Mozzie-AU/ESPLeafSOC/hardware/case/LeafSOCdisplay OLED 128x64 1p30in v09.stl

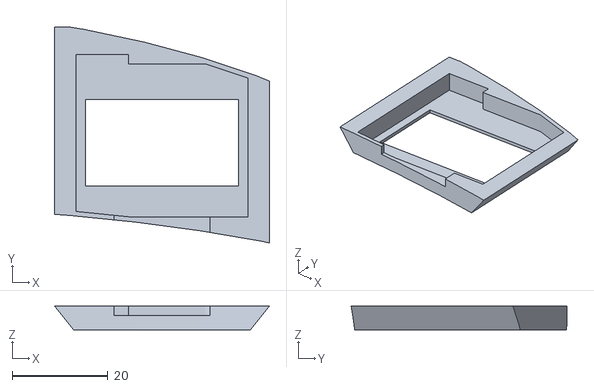
[picture p4: CAD file, 2026-06-22]
hardware/case/LeafSOCdisplay OLED 128x64 1p30in v09.stl
45.0 x 45.2 x 5.00
