Mozzie-AU/ESPLeafSOC/hardware/case/LeafSOCdisplay OLED 128x64 0p96inch v05.stl

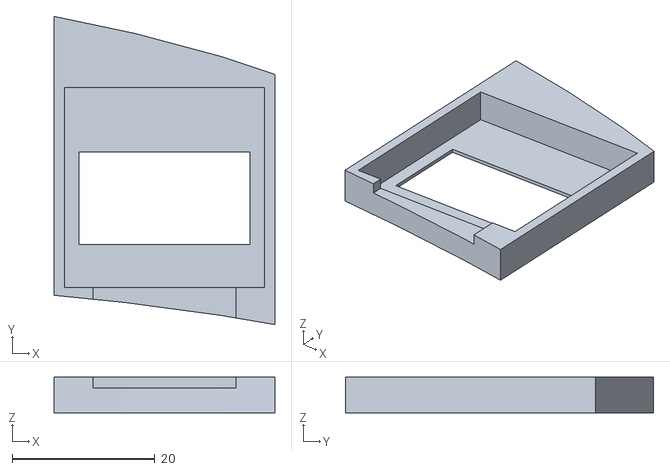
[picture p5: CAD file, 2026-06-22]
hardware/case/LeafSOCdisplay OLED 128x64 0p96inch v05.stl
31.0 x 43.2 x 5.00
