Mozzie-AU/ESPLeafSOC/hardware/case/LeafSOC box and lid v13.stl

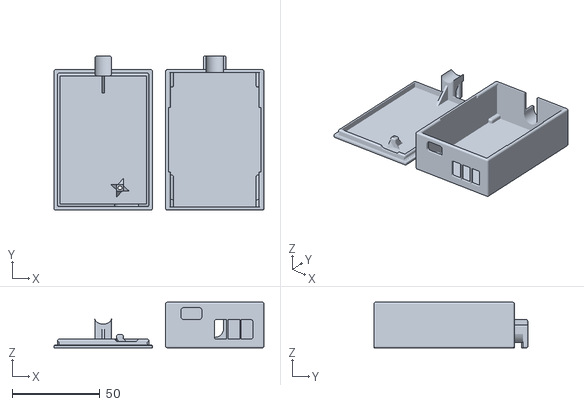
[picture p6: CAD file, 2026-06-22]
hardware/case/LeafSOC box and lid v13.stl
119.5 x 87.9 x 26.0
