Mozzie-AU/ESPLeafSOC/hardware/case/LeafSOCdisplay OLED 128x64 1p54inch v05.stl

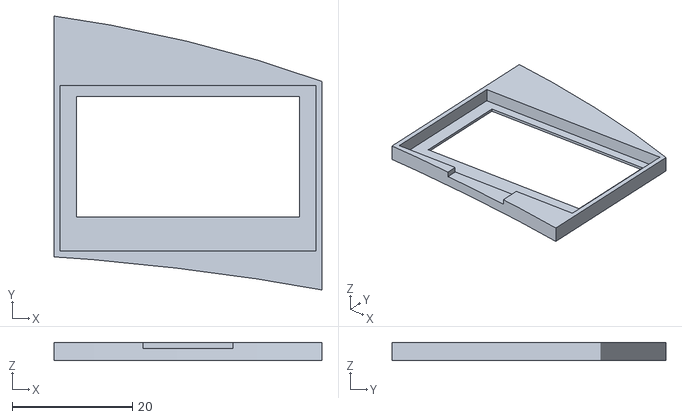
[picture p7: CAD file, 2026-06-22]
hardware/case/LeafSOCdisplay OLED 128x64 1p54inch v05.stl
44.5 x 45.5 x 3.00
