Mozzie-AU/ESPLeafSOC/(commit log)

2026-06-11 Remove old Arduino Nano ino files - ESP32 refactor starting
2026-06-11 Add ESPLeafSOC_v01.ino - initial ESP32 skeleton
2026-06-11 Add ESPLeafSOC_v01 - confirmed T-CAN485 pin assignments from pinout diagram
2026-06-11 Rename to ESPLeafSOC.ino - Arduino IDE requires sketch name matches folder
2026-06-12 v02 - Switch OLED to hardware SPI, dual SH1106/SSD1306 constructors, add contribution note
2026-06-17 v11 - recovered and merged manual layout fixes with maxGids/web portal changes
    [ESPLeafSOC.ino]
2026-06-19 v12 - add diagnostics page 5 for on-device rawGids/maxGids checking
2026-06-20 v14 - remove maxGids/packType/GidsPct, BMS SOC% is now sole source of truth
2026-06-21 v19 - fix invisible SOC% text on page 1 (white-on-white over solid battery icon)
    [ESPLeafSOC.ino]
2026-06-21 v20 - decode Battery SoH% from existing CAN 0x5BC message, no second CAN bus needed
2026-06-22 Restructure hardware files into /hardware subfolder, rewrite README for T-CAN485
    [LeafSOC box and lid v13.stl, LeafSOCdisplay OLED 128x64 0p96inch v05.stl, LeafSOCdisplay OLED 128x64 1p30in v09.stl, LeafSOCdisplay OLED 128x64 1p54inch v05.stl]
2026-06-22 Rename OLED adapter Gerber file for clarity
2026-06-22 Add hardware BOM, link from README
2026-06-23 Add T-CAN485 wiring diagram, replacing need to cross-reference Paul's original Arduino sketch
2026-06-23 Fix OBD2 pinout errors in wiring diagram: CAN H/L swap, GND pin and endpoint
